Bass0315/LiteDe/03_UserFirmware/Firmware_20211221/README.md

# 功能添加说明
## 2022_12_21
>Only board program
