Bass0315/LiteDe/03_UserFirmware/Firmware_backup/README.md

# 功能添加说明
## 2022_12_21
>Only board program

## 2022_02_17
>Add ADS1115

## 2022_02_23
>Add TAC9548A IIC hub
