Bass0315/LiteDe/02_Hardware/santa cruz iot rev0.72 20201217.pdf

# Oct. 16 2020

# REVISION

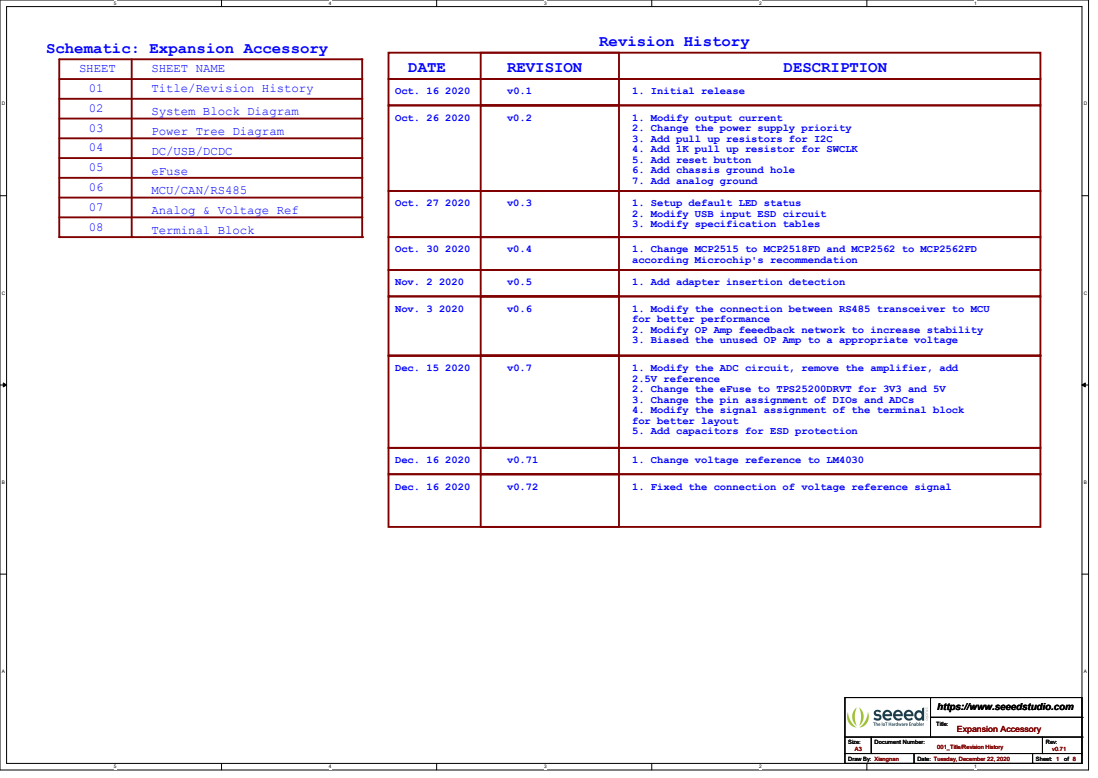
[picture p1: page 1]
DESCRIPTION; 1. Initial release; DATE; Revision History; Oct. 26 2020; Oct. 27 2020; 1. Setup default LED status; Oct. 30 2020; 1. Change MCP2515 to MCP2518FD and MCP2562 to MCP2562FD; Nov. 2 2020; 1. Add adapter insertion detection; Nov. 3 2020; Dec. 15 2020; Dec. 16 2020; 1. Change voltage reference to LM4030; 1. Fixed the connection of voltage reference signal v0.72; Title: Size:; Document Number:; Rev: Draw By:; Date:; Sheet:; https://www.seeedstudio.com A3; v0.71 Xiangnan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

Schematic: Expansion Accessory

SHEET | SHEET NAME
01 | Title/Revision History
02 | System Block Diagram
03 | Power Tree Diagram
04 | DC/USB/DCDC
05 | eFuse
06 | MCU/CAN/RS485
07 | Analog & Voltage Ref
08 | Terminal Block

1. Modify output current
2. Change the power supply priority
3. Add pull up resistors for I2C
4. Add 1K pull up resistor for SWCLK
5. Add reset button
6. Add chassis ground hole
7. Add analog ground

2. Modify USB input ESD circuit
3. Modify specification tables

according Microchip's recommendation

1. Modify the connection between RS485 transceiver to MCU
for better performance
2. Modify OP Amp feeedback network to increase stability
3. Biased the unused OP Amp to a appropriate voltage

1. Modify the ADC circuit, remove the amplifier, add
2.5V reference
2. Change the eFuse to TPS25200DRVT for 3V3 and 5V
3. Change the pin assignment of DIOs and ADCs
4. Modify the signal assignment of the terminal block
for better layout
5. Add capacitors for ESD protection

# System Block Diagram

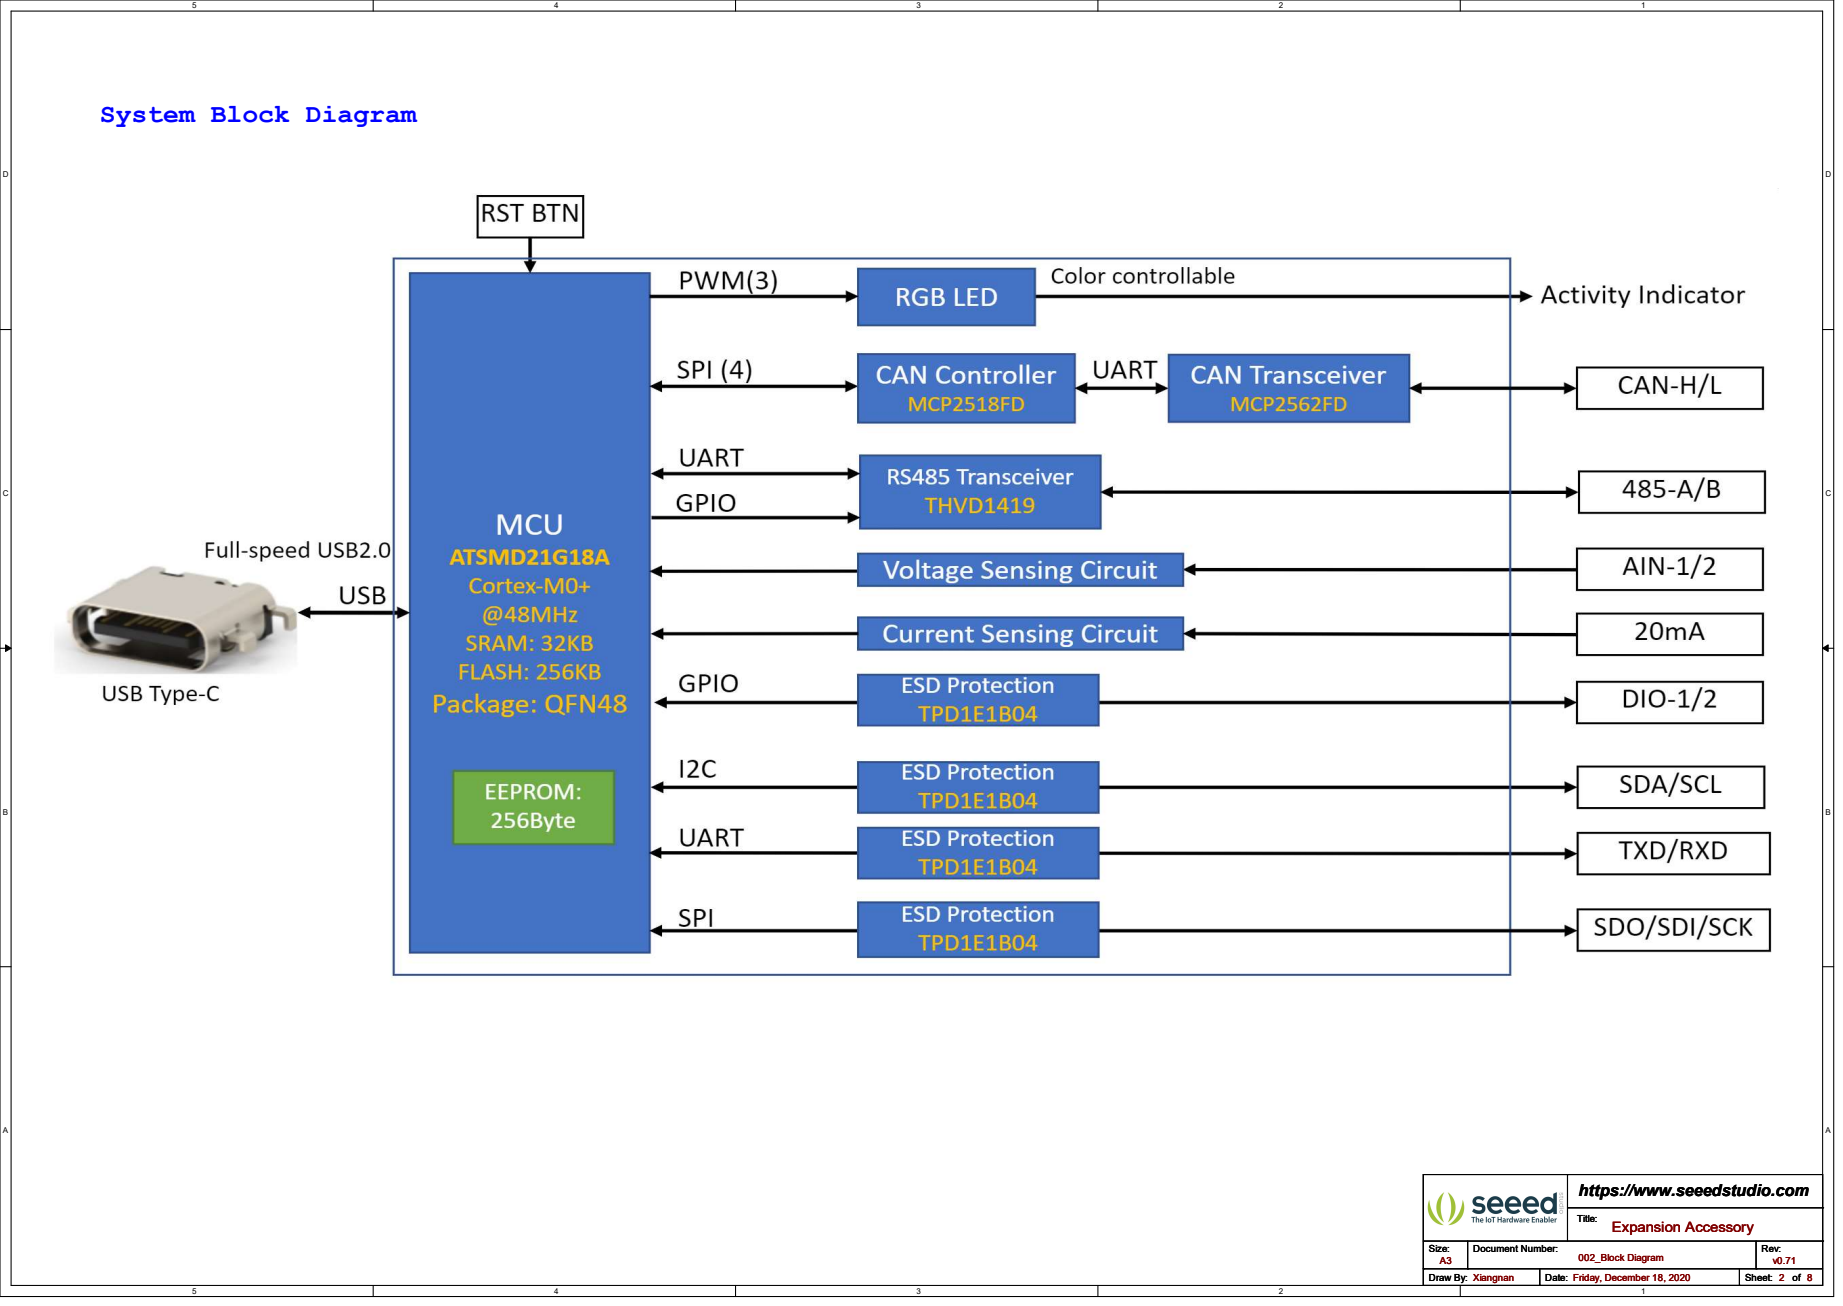
[picture p2: page 2]
https://www.seeedstudio.com A3; v0.71 Xiangnan; Friday, December 18, 2020; 8 Expansion Accessory 002_Block Diagram

Power tree | 5V 0.9A

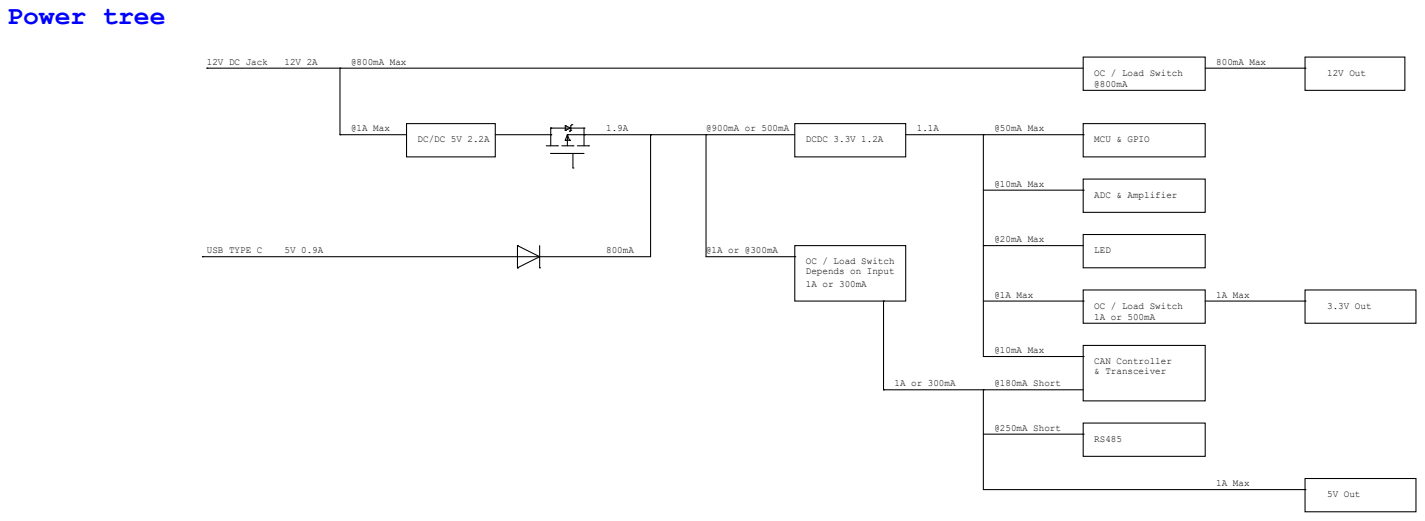
[picture p3: page 3]
LED; @10mA Max; 12V DC Jack; DCDC 3.3V 1.2A; CAN Controller & Transceiver; ADC & Amplifier; @800mA Max; 5V Out; 800mA Max; @1A Max; 1A Max; MCU & GPIO; @50mA Max; @20mA Max; 3.3V Out; 12V Out; @250mA Short; @180mA Short; USB TYPE C; https://www.seeedstudio.com A3; v0.71 Xiangnan; Friday, December 18, 2020; 8 Expansion Accessory 003_Power Tree Diagram

OC / Load Switch

Depends on Input

# 12V DC INPUT

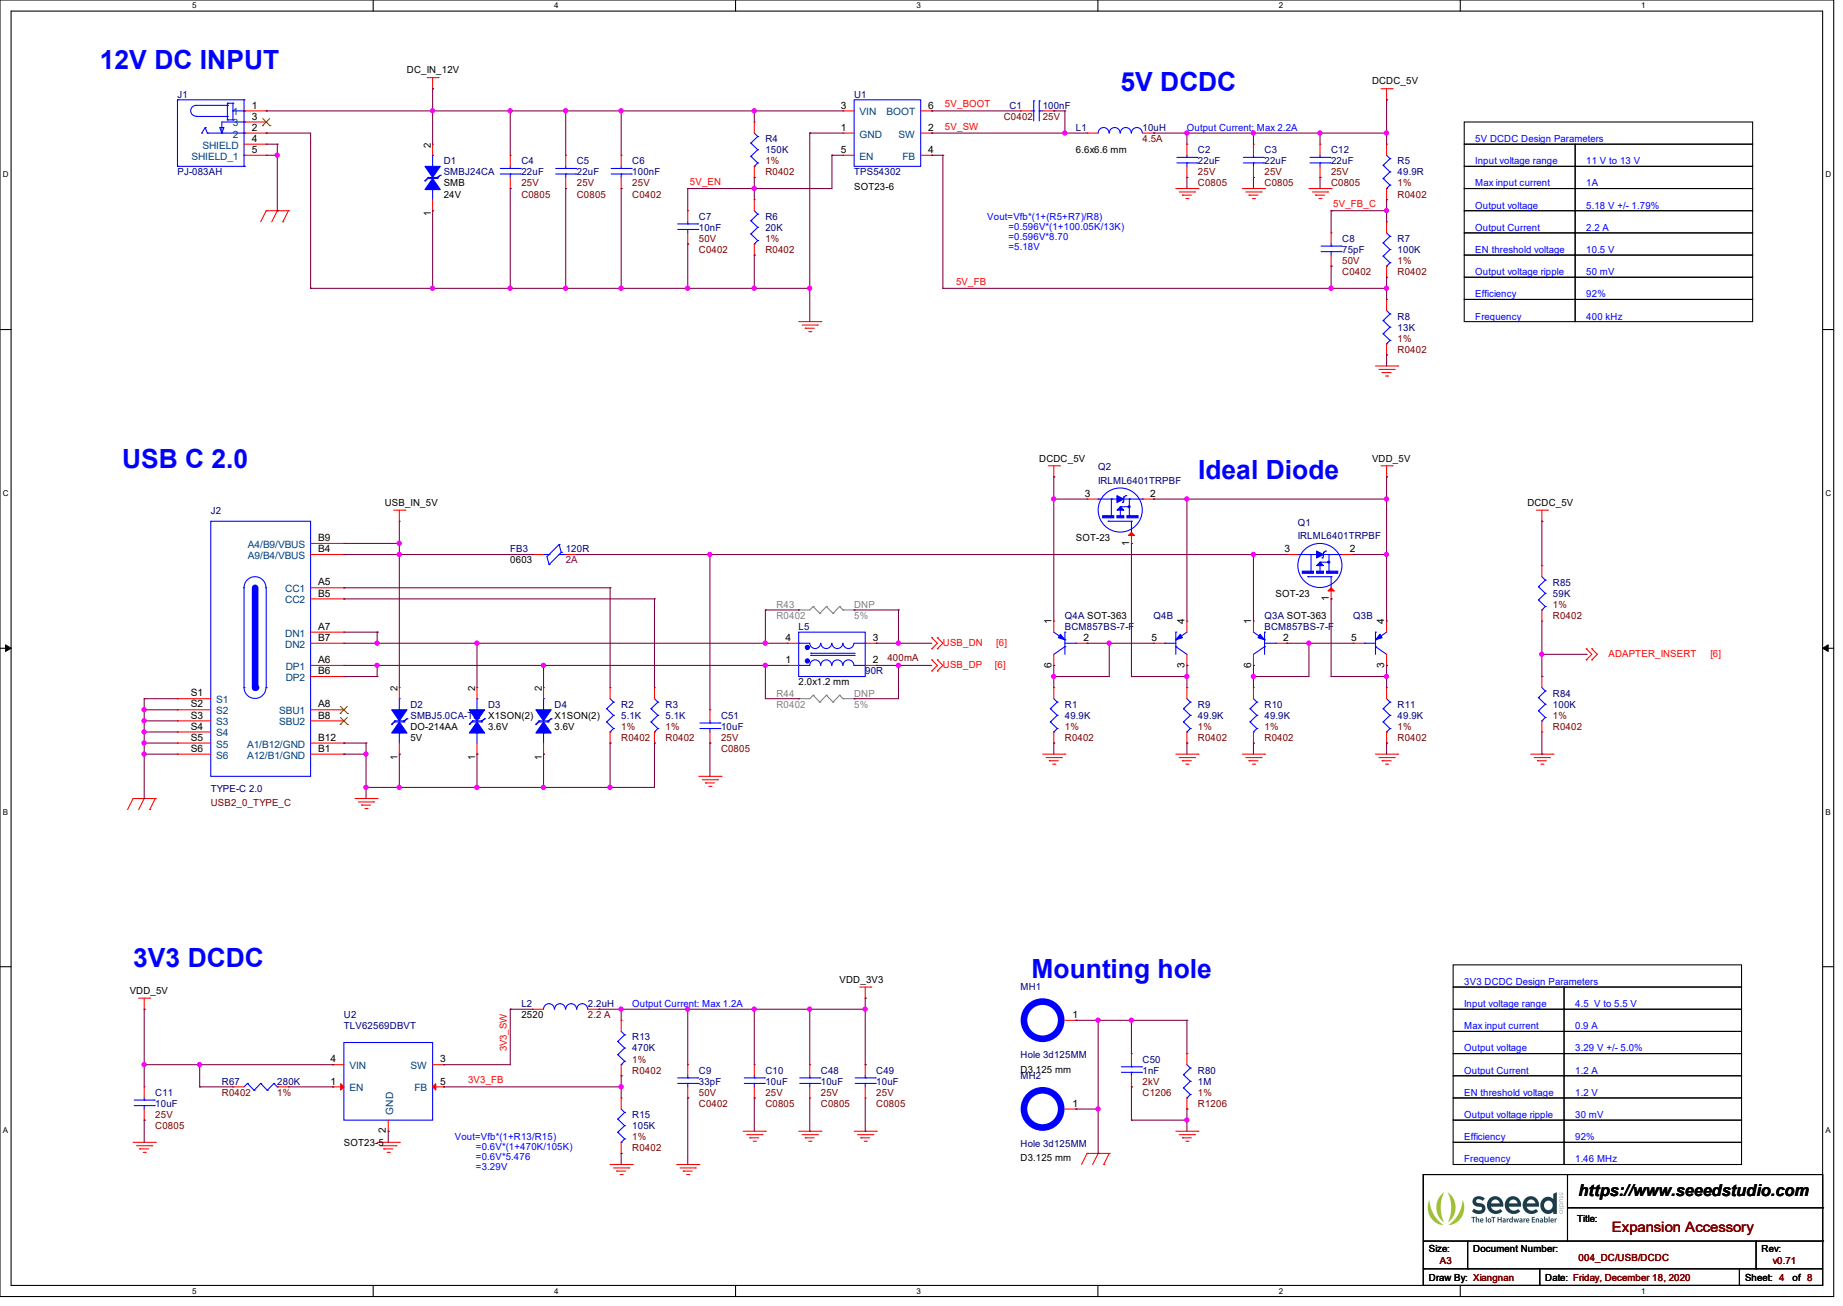
[picture p4: page 4]

CC1 A5 DP1 A6 DN1 A7 SBU1 A8 A1/B12/GND B12 A12/B1/GND B1 A9/B4/VBUS B4 CC2 B5 DP2 B6 DN2 B7 SBU2 B8 A4/B9/VBUS B9 S1 S1 S2 S2 S3 S3 S4 S4 S5 S5 S6 S6

# 12V eFuse

# OUT_12V OUT_5V OUT_3V3

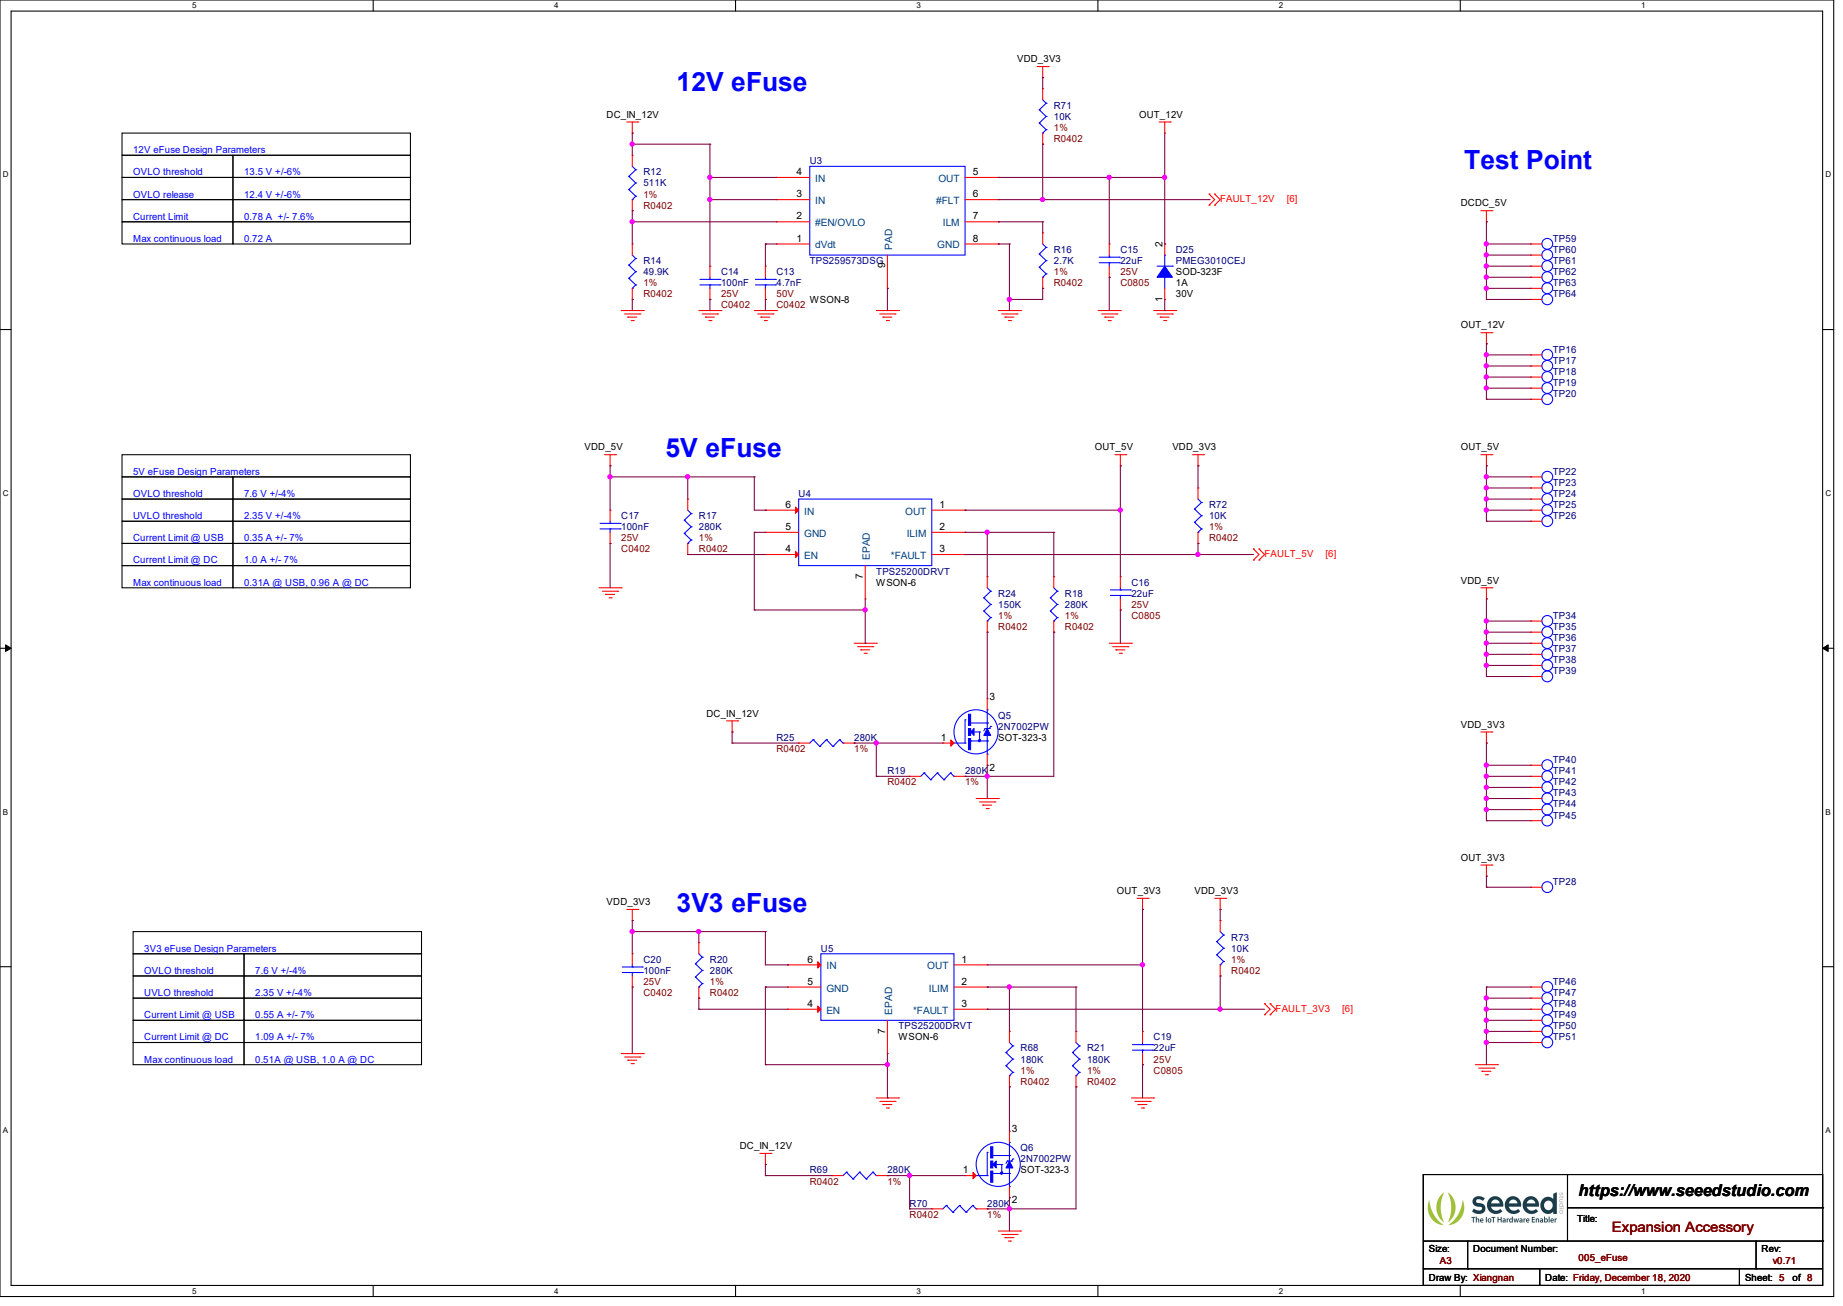
[picture p5: page 5]

5V eFuse Design Parameters OVLO threshold

# MCU

PA02_ADC0 | [7] PA03_ADCREF | [7] SCK | [8] SDI | [8] SDO | [8] TXD | [8] RXD | [8] SDA | [8] SCL | [8] USB_DN | [4] USB_DP | [4]

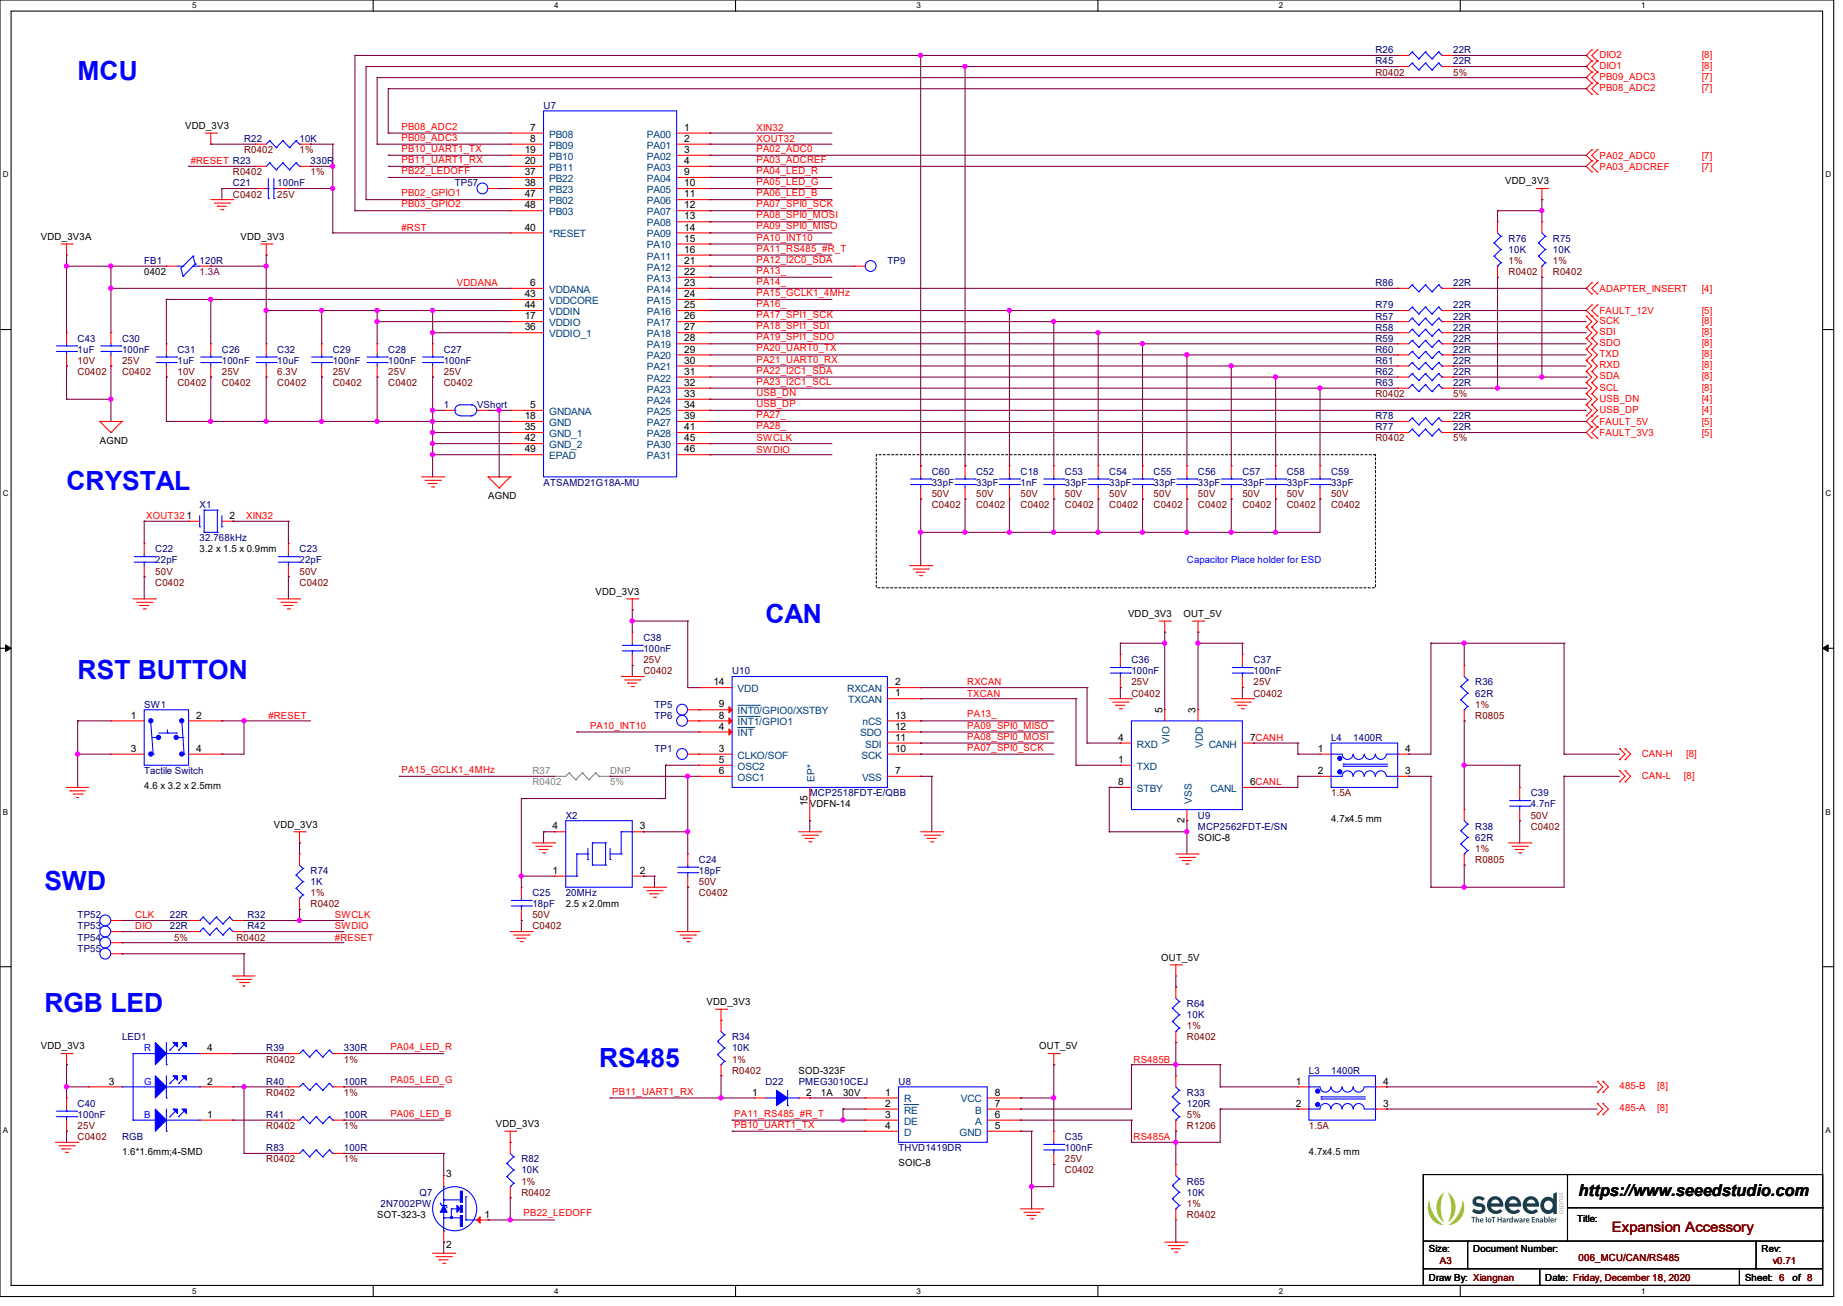
[picture p6: page 6]

PB02 47 PB03 48 PB08 7 PB09 8 PB10 19 PB11 20 PB22 37 PB23 38 EPAD 49 GND 18 GNDANA 5 GND_1 35 GND_2 42 VDDANA 6 VDDCORE 43 VDDIN 44 VDDIO 17 VDDIO_1 36

Capacitor Place holder for ESD

VDFN-14TXCAN 1 RXCAN 2 CLKO/SOF 3

# 1x Analog Current Inputs 4~20mA

# Voltage Refference 2.5V Close to MCU

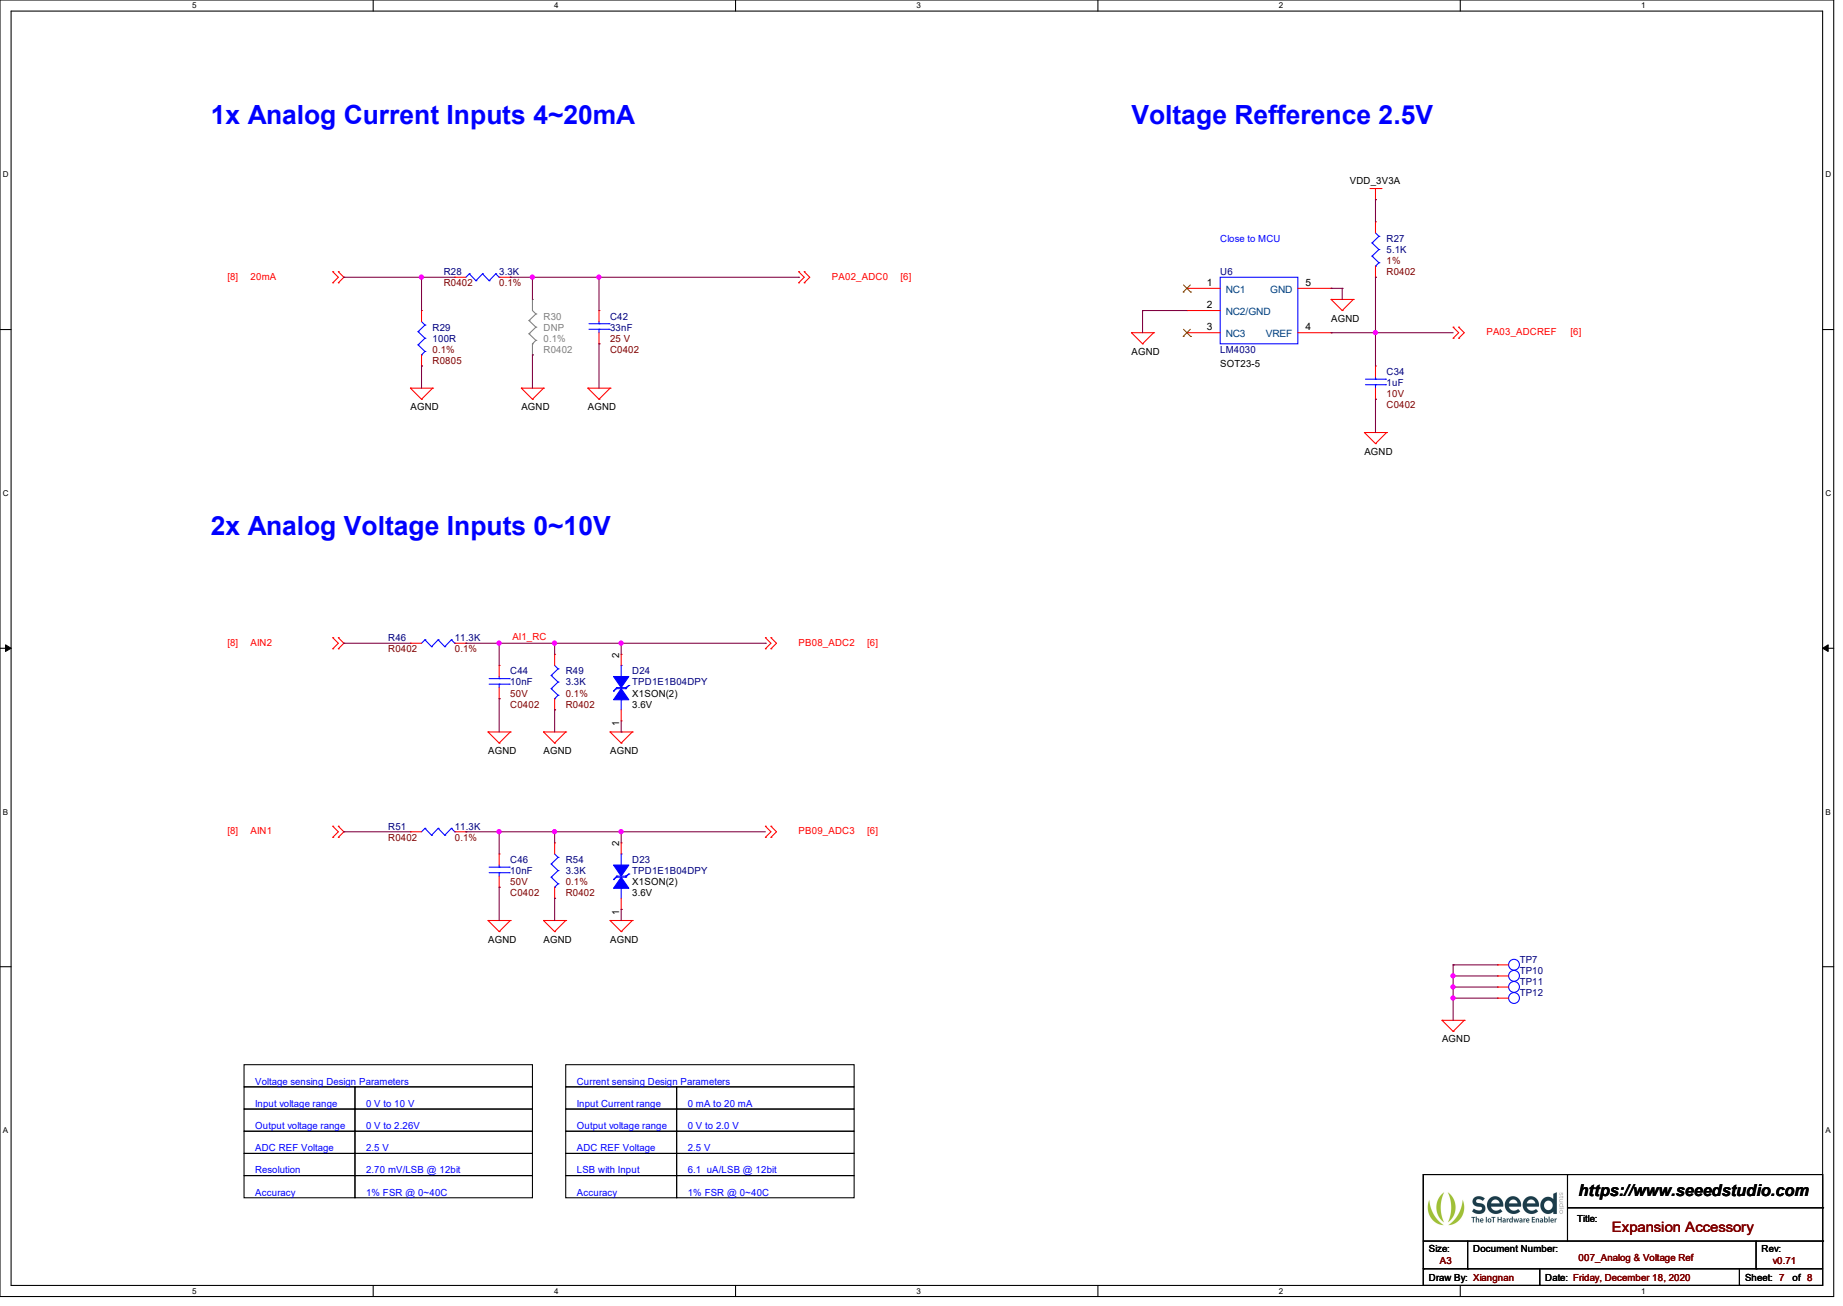
[picture p7: page 7]

Output voltage range Voltage sensing Design Parameters 0 V to 2.26V

# Terminal Block

# J5EK500V-7464-12P

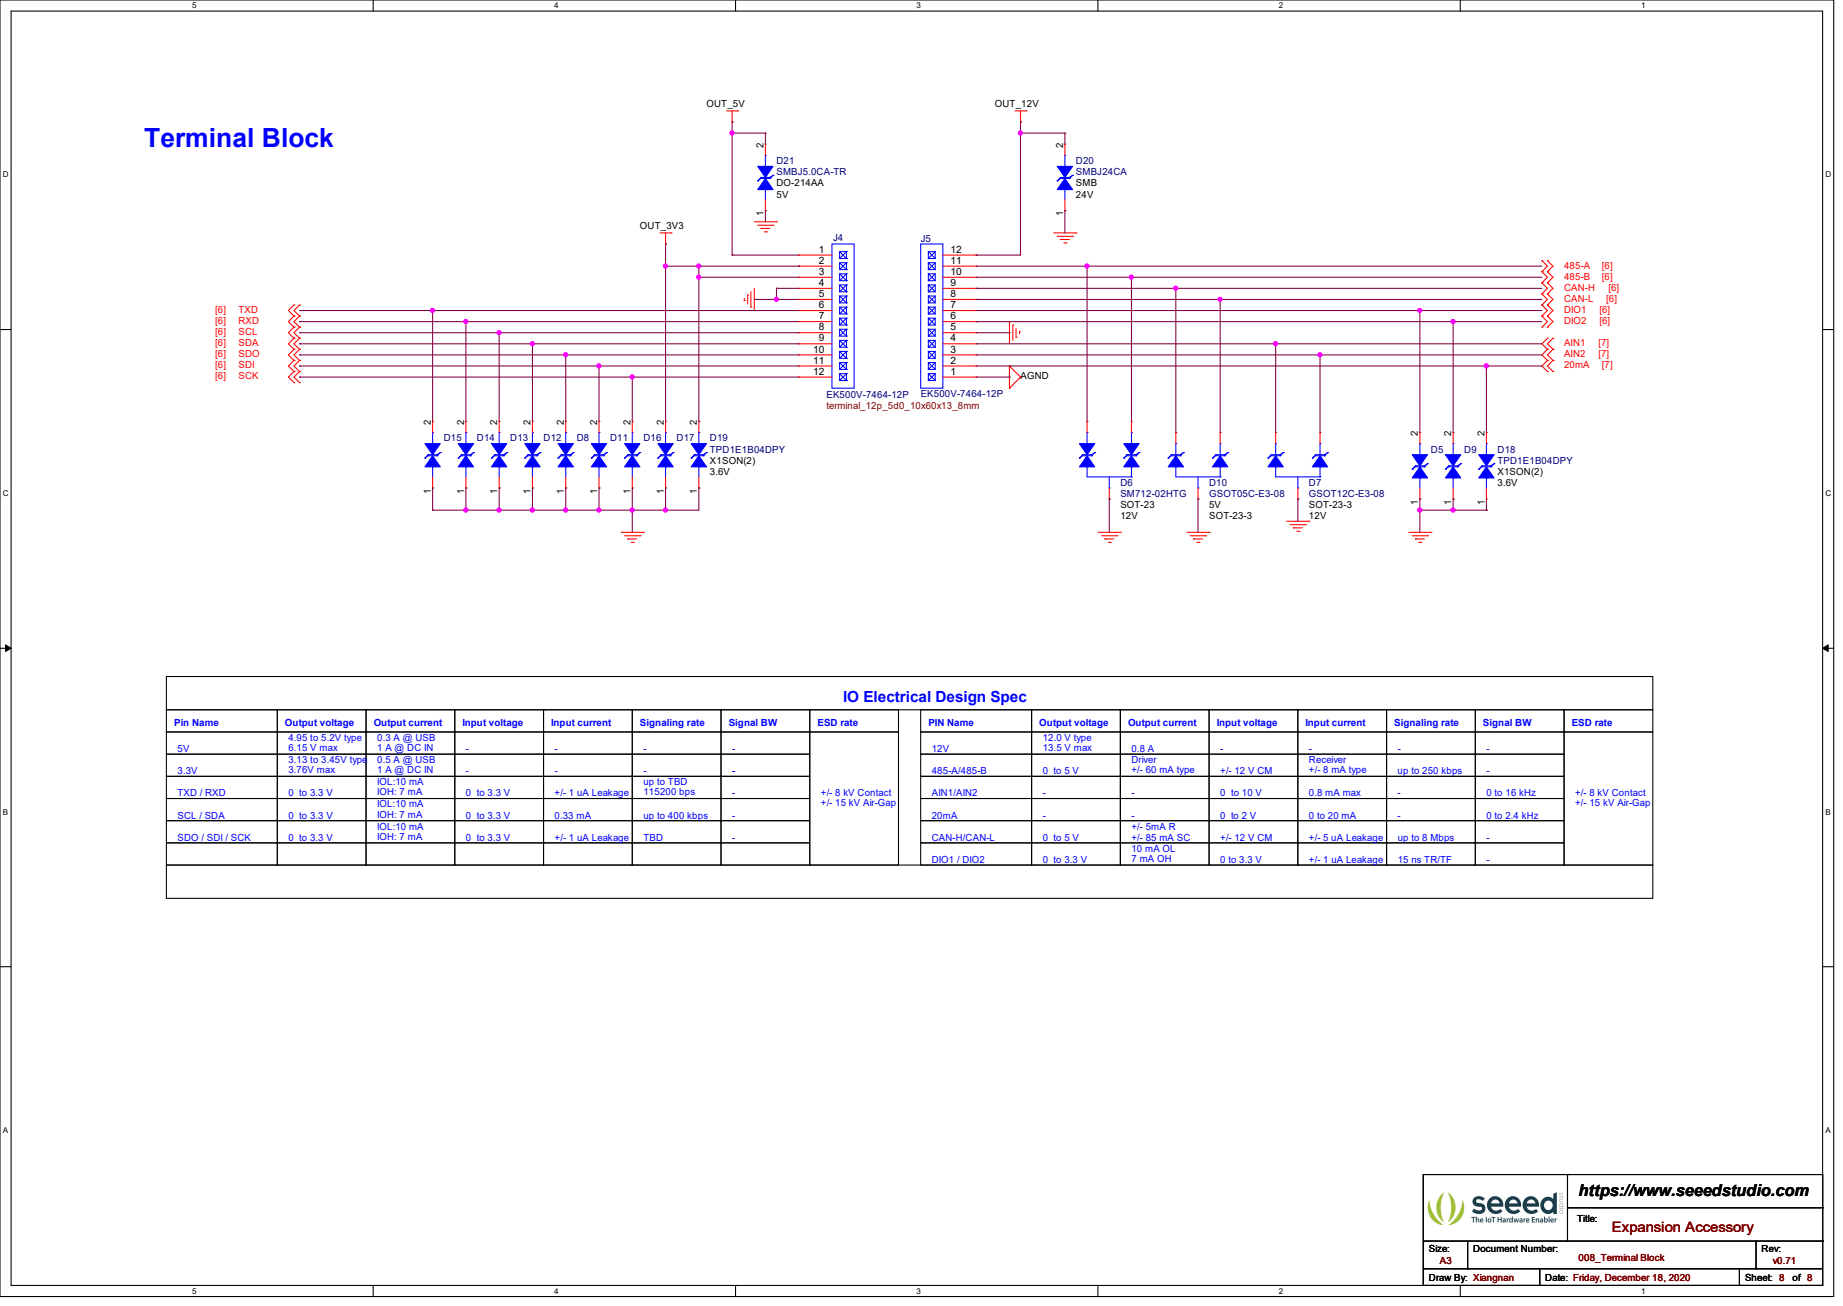
[picture p8: page 8]

Signaling rate 0.8 mA max

+/- 8 kV Contact +/- 15 kV Air-Gap
