Bass0315/LiteDe/03_UserFirmware/Firmware_20220223/Firmware_20220223.ino

/*
    library:
    https://github.com/e-radionicacom/Soldered-CAN-Bus-Breakout-MCP2518-Arduino-Library.git
    

*/

#include "Scr.h"

//ADS1115 ADC
#include "User_ADS1115_ADC.h"
ADS1115<TwoWire> ads(Wire);//IIC


//TCA9548A IIC HUB
#include "User_TCA9548A_IICHub.h"
TCA9548A<TwoWire> TCA;



String rec_string = "";
bool command_flag = false;




/**
   @
   @
   @
*/
void setup()
{
  Sys_Init();
}

/**
   @
   @
   @
*/
void loop()
{
  SerialUART_Recive();
  CAN_Recive();
  RS485_Recive();

  if (SerialUSB_Recive())
  {
    SerialUART_Send();
    CAN_Send();
    RS485_Send();
  
    ADC_AINxx();
    DIOxx();
    
    ADS1115_Com();
    HubIICScan_Com();

    if (!command_flag)
    {
      SerialUSB.println("ERROR: Command is error,Please input again.");
      SerialUSB.println("Baord: ");
      SerialUSB.println("uart/rs485/can<address>/adc/io1/io2 or exit.");
      SerialUSB.println(" ");
      SerialUSB.println("Funtion: ");
      SerialUSB.println("ads1115_<0x48/0x49/0x4A/0x4B>");
      SerialUSB.println("tca9548a_scan");
    }
    else
      SerialUSB.println("Stop command.");
    command_flag = false;
    rec_string = "";
  }
}
