Bass0315/LiteDe/02_Hardware/gerber Santa Cruz IoT v0.7_20201222/nc_param.txt

INTEGER-PLACES         2
DECIMAL-PLACES         5
X-OFFSET               0.000000
Y-OFFSET               0.000000
FEEDRATE               1
COORDINATES            ABSOLUTE
OUTPUT-UNITS           ENGLISH
TOOL-ORDER             INCREASING
REPEAT-CODES           YES
SUPPRESS-LEAD-ZEROES   NO
SUPPRESS-TRAIL-ZEROES  NO
SUPPRESS-EQUAL         NO
TOOL-SELECT            YES
OPTIMIZE_DRILLING      NO
ENHANCED_EXCELLON      YES
HEADER                 none
LEADER                 12
CODE                   ASCII
SEPARATE               NO
SEPARATE-ROUTING       NO
DRILLING               LAYER-PAIR
BACKDRILL              NO
CAVITY                 NO
COUNTER                NO
TOLERANCE_DRILL        YES
TOLERANCE_TRAVEL       YES
TOOL_SIZE              YES
ROTATION               YES
NON_STANDARD           YES
TOTAL_DRILL            YES
SEPARATE_SLOT          YES
SUPPRESS_TOLERANCE     YES
SUPPRESS_TOOLSIZE      YES
SUPPRESS_ROTATION      YES
